Lenart12/etera-uart-bridge/pcb/optocupler.kicad_pcb

## KiCad design pcb/optocupler.kicad_pcb (2024-07-26)

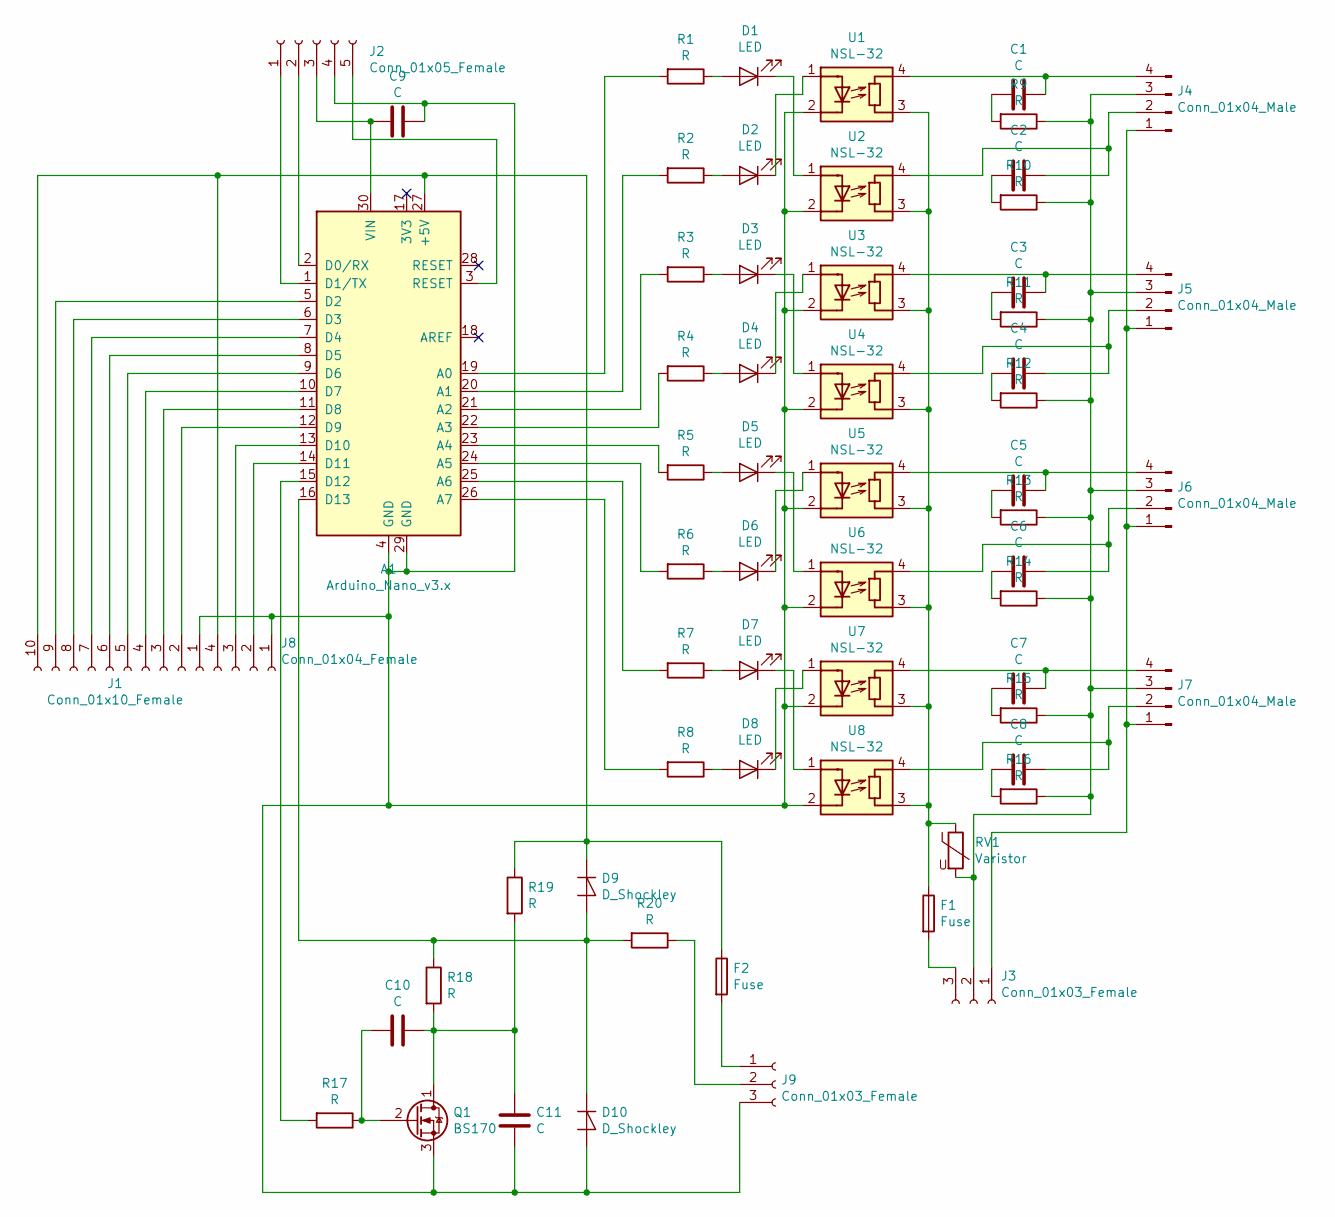
[picture p4: schematic optocupler.sch]

Parts:
A1: Arduino_Nano_v3.x; Arduino_Nano
C1, C2, C3, C4, C5, C6, C7, C8: C; C_Axial_L17.0mm_D6.5mm_P20.00mm_Horizontal
C9, C10, C11: C; C_Disc_D4.7mm_W2.5mm_P5.00mm
D1, D2, D3, D4, D5, D6, D7, D8: LED; LED_D5.0mm
D9, D10: D_Shockley; D_A-405_P10.16mm_Horizontal
F1, F2: Fuse; Fuseholder_Cylinder-5x20mm_Stelvio-Kontek_PTF78_Horizontal_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
J1: Conn_01x10_Female; PinSocket_1x10_P2.54mm_Vertical
J2: Conn_01x05_Female; PinSocket_1x05_P2.54mm_Vertical
J3, J9: Conn_01x03_Female; JST_NV_B03P-NV_1x03_P5.00mm_Vertical
J4, J5, J6, J7: Conn_01x04_Male; PhoenixContact_MSTBVA_2,5_4-G_1x04_P5.00mm_Vertical
J8: Conn_01x04_Female; PinSocket_1x04_P2.54mm_Vertical
Q1: BS170; TO-92_Inline
R1, R2, R3, R4, R5, R6, R7, R8, R9, R10, R11, R12, R13, R14, R15, R16, R17, R18, R19, R20: R; R_Axial_DIN0411_L9.9mm_D3.6mm_P12.70mm_Horizontal
RV1: Varistor; RV_Disc_D15.5mm_W4mm_P7.5mm
U1, U2, U3, U4, U5, U6, U7, U8: NSL-32; DIP-5-6_W7.62mm_LongPads

Connections:
unnamed: A1.1 (D1/TX), J2.1
unnamed: A1.2 (D0/RX), J2.2
unnamed: A1.3 (RESET), J2.5
unnamed: A1.5 (D2), J1.9
unnamed: A1.6 (D3), J1.8
unnamed: A1.7 (D4), J1.7
unnamed: A1.8 (D5), J1.6
unnamed: A1.9 (D6), J1.5
unnamed: A1.10 (D7), J1.4
unnamed: A1.11 (D8), J1.3
unnamed: A1.12 (D9), J1.2
unnamed: A1.13 (D10), J8.3
unnamed: A1.14 (D11), J8.2
unnamed: A1.15 (D12), R17.2
unnamed: A1.16 (D13), D9.2 (A), D10.1 (K), R18.1, R20.2
unnamed: A1.19 (A0), R1.2
unnamed: A1.20 (A1), R2.2
unnamed: A1.21 (A2), R3.2
unnamed: A1.22 (A3), R4.2
unnamed: A1.23 (A4), R5.2
unnamed: A1.24 (A5), R6.2
unnamed: A1.25 (A6), R7.2
unnamed: A1.26 (A7), R8.2
unnamed: A1.27 (+5V), D9.1 (K), F2.1, J1.10, J8.4, R19.1
unnamed: A1.4 (GND), A1.29 (GND), C9.1, C11.2, D10.2 (A), J1.1, J2.4, J8.1, J9.3, Q1.3 (S), U1.2 (K), U2.2 (K), U3.2 (K), U4.2 (K), U5.2 (K), U6.2 (K), U7.2 (K), U8.2 (K)
unnamed: A1.30 (VIN), C9.2, J2.3
unnamed: C1.1, R9.2
unnamed: C1.2, J4.4, U1.4 (R)
unnamed: C2.1, R10.2
unnamed: C2.2, J4.2, U2.4 (R)
unnamed: C3.1, R11.2
unnamed: C3.2, J5.4, U3.4 (R)
unnamed: C4.1, R12.2
unnamed: C4.2, J5.2, U4.4 (R)
unnamed: C5.1, R13.2
unnamed: C5.2, J6.4, U5.4 (R)
unnamed: C6.1, R14.2
unnamed: C6.2, J6.2, U6.4 (R)
unnamed: C7.1, R15.2
unnamed: C7.2, J7.4, U7.4 (R)
unnamed: C8.1, R16.2
unnamed: C8.2, J7.2, U8.4 (R)
unnamed: C10.1, C11.1, Q1.1 (D), R18.2, R19.2
unnamed: C10.2, Q1.2 (G), R17.1
unnamed: D1.1 (K), U2.1 (A)
unnamed: D1.2 (A), R1.1
unnamed: D2.1 (K), U1.1 (A)
unnamed: D2.2 (A), R2.1
unnamed: D3.1 (K), U4.1 (A)
unnamed: D3.2 (A), R3.1
unnamed: D4.1 (K), U3.1 (A)
unnamed: D4.2 (A), R4.1
unnamed: D5.1 (K), U6.1 (A)
unnamed: D5.2 (A), R5.1
unnamed: D6.1 (K), U5.1 (A)
unnamed: D6.2 (A), R6.1
unnamed: D7.1 (K), U8.1 (A)
unnamed: D7.2 (A), R7.1
unnamed: D8.1 (K), U7.1 (A)
unnamed: D8.2 (A), R8.1
unnamed: F1.1, RV1.1, U1.3 (R), U2.3 (R), U3.3 (R), U4.3 (R), U5.3 (R), U6.3 (R), U7.3 (R), U8.3 (R)
unnamed: F1.2, J3.3
unnamed: F2.2, J9.1
unnamed: J3.1, J4.1, J5.1, J6.1, J7.1
unnamed: J3.2, J4.3, J5.3, J6.3, J7.3, R9.1, R10.1, R11.1, R12.1, R13.1, R14.1, R15.1, R16.1, RV1.2
unnamed: J9.2, R20.1

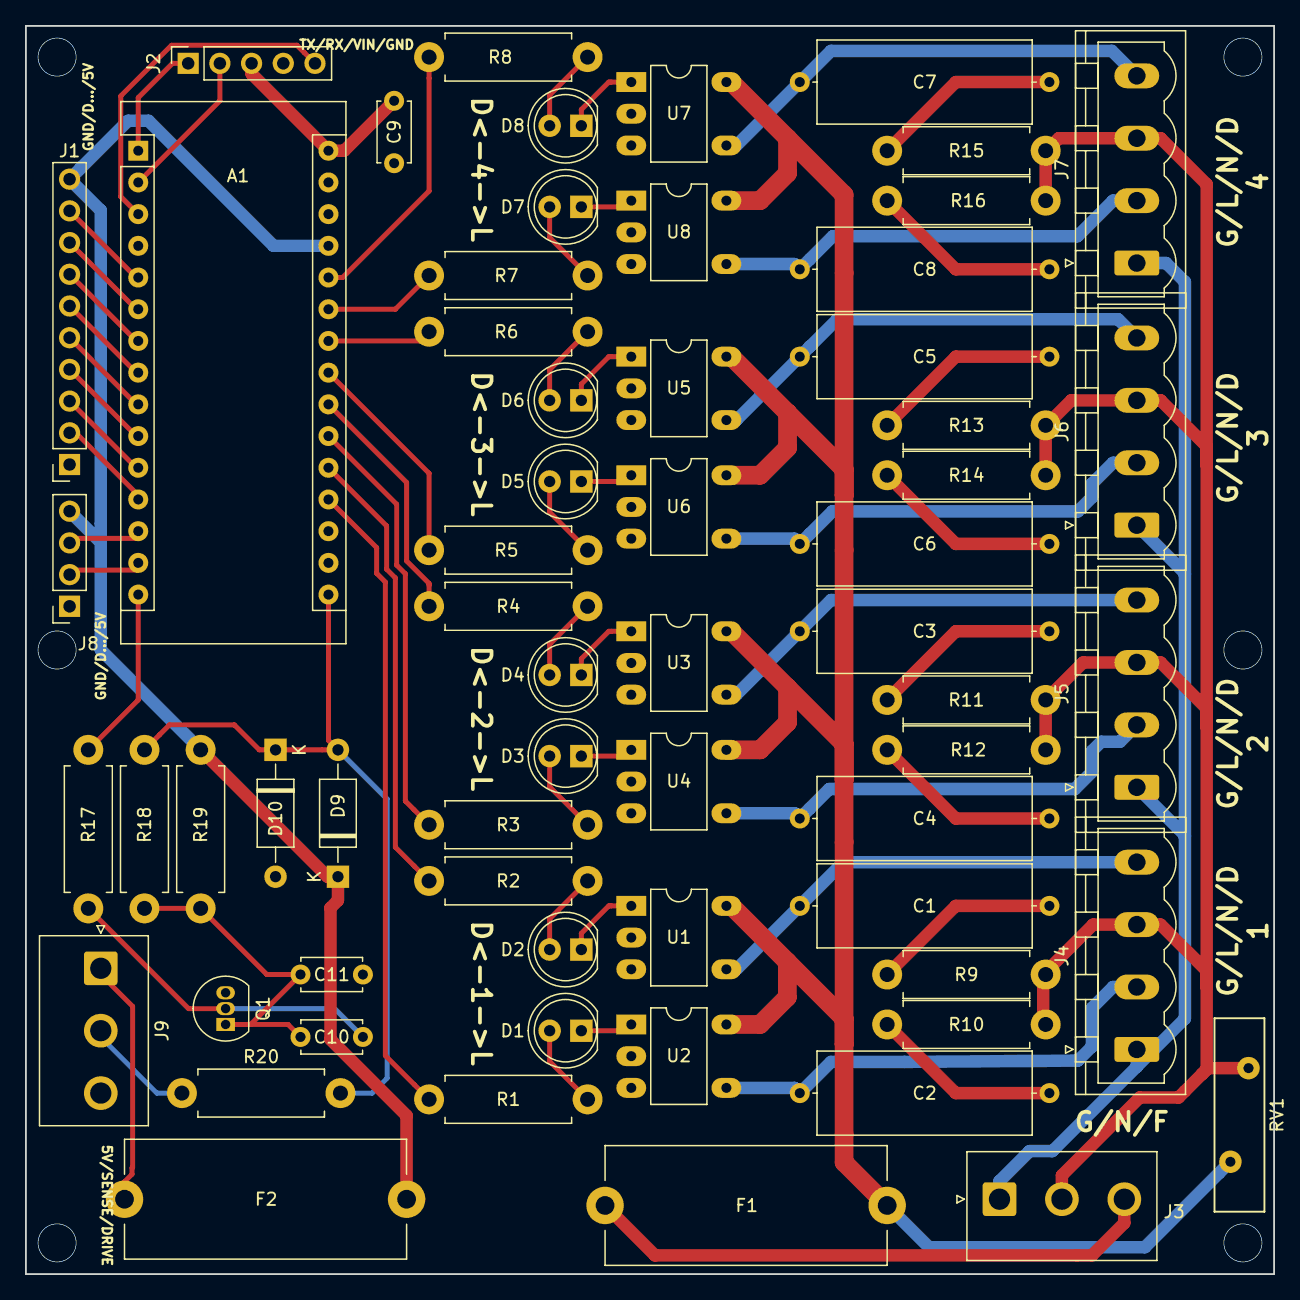
[picture p5: board optocupler.kicad_pcb from above]

Board: 2 copper layers, 100.0 x 100.0 mm, 63 parts (0 on the bottom side), 66 nets.
