Lenart12/etera-uart-bridge/pio-eub-firmware/src/TempController.cpp

#if !defined(__TEMP_CONTROLLER_CPP__)
#define __TEMP_CONTROLLER_CPP__

#include "TempController.hpp"
#include "ApplicationDefines.h"

void TempController::switch_state(State next, unsigned long timeout) {
    if (state != next) {
        state_start_millis = millis();
    }
    next_state.switch_state(state, next, timeout);
}

void TempController::NextState::switch_state(State& current, State next, unsigned long timeout) {
    if (timeout == 0) {
        current = next;
        return;
    }
    current = State::WAIT_SWITCH_STATE;
    state = next;
    timeout_start = millis();
    timeout_delay = timeout;
}

bool TempController::NextState::process_wait(State& current) {
    if (millis() - timeout_start < timeout_delay) return false;
    current = state;
    return true;
}

void PrintHex8_(uint8_t *data, uint8_t length) {
    for (int i = 0; i < length; i++) {
        if (data[i] < 0x10) Serial.print('0');
        Serial.print(data[i], HEX);
        if (i < length -1)
            Serial.print(':');
    }
}

void TempController::Process() {
    switch (state)
    {
    case State::SETUP: {
        // Free the memory if it was allocated before
        if (results) delete[] results;
        results = nullptr;

        #ifdef DEBUG_TEMP
        if (raw_temp) delete[] raw_temp;
        raw_temp = nullptr;
        if (count_remain) delete [] count_remain;
        count_remain = nullptr;
        #endif

        if (devices) {
            for (int i = 0; i < device_count; i++)
                delete[] devices[i];
            delete[] devices;
        }
        devices = nullptr;
        
        device_count = 0;
        last_read_millis = 0;

        if (!ds.reset()) {
            static bool shown_error = false;
            if (!shown_error) {
                TC_PRINTLN("1-Wire bus not found!");
                shown_error = true;
            }
            return;
        }

        // Get the number of devices on the bus
        byte addr[8];
        ds.reset_search();
        while (ds.search(addr)) device_count++;

        if (device_count == 0) {
            static bool shown_error = false;
            if (!shown_error) {
                TC_PRINTLN("No 1-Wire devices found!");
                shown_error = true;
            }
            return;
        }

        // Allocate memory for the results
        results = new int16_t[device_count];
        #ifdef DEBUG_TEMP
        raw_temp = new uint16_t[device_count];
        count_remain = new uint16_t[device_count];
        #endif
        #ifdef DOT765
        previous_temperature = new int16_t[device_count];
        #endif
        // Allocate memory for the addresses
        devices = new uint8_t*[device_count];
        for (int i = 0; i < device_count; i++) {
            results[i] = 0xFFFF;
            devices[i] = new uint8_t[8];
            #ifdef DOT765
            // Initialize to large positive temp so that
            // the previous temperature reading could not be used first time in a loop
            previous_temperature[i] = 0x8000; // Max signed int
            #endif
        }

        // Get the addresses of the devices
        ds.reset_search();
        for (int i = 0; i < device_count; i++)
        {
            ds.search(addr);
            for (int j = 0; j < 8; j++) devices[i][j] = addr[j];
        }

        TC_PRINT_START();
        Serial.print("Temperature Controller setup found ");
        Serial.print(device_count, DEC);
        Serial.println(" sensors.");
        Serial.println("Addresses:");
        for (int i = 0; i < device_count; i++) {
            Serial.print("#"); Serial.print(i, DEC);
            Serial.print("\t"); PrintHex8_(devices[i], 8);

            #ifdef READ_POWER_STATE
            ds.reset();
            ds.select(devices[i]);
            ds.write(0xB4); // Read power state command
            uint8_t power_state = ds.read_bit();
            Serial.print('\t');
            Serial.print(power_state ? "External" : "Parasite");
            #endif

            Serial.println();
        }
        TC_PRINT_END();


        switch_state(State::START_CONVERSION);
        break;
    }
    case State::START_CONVERSION: {
        ds.reset();
        ds.skip(); // We select all sensors and
        ds.write(0x44); // Start temperature conversion

        switch_state(State::WAIT_CONVERSION, 500);
        break;
    }
    case State::WAIT_CONVERSION: {
        // Check if the conversion is done every 5ms
        if (!ds.read_bit())
            return switch_state(state, 5);

        // Check for conversion timeout (2 seconds)
        if (millis() - state_start_millis > 2000) {
            TC_PRINTLN("Temperature conversion timeout!");
            switch_state(State::RESET_BUS, 1000);
            return;
        }

        current_device = 0;
        crc_error_count = 0;
        switch_state(State::READ);
        break;
    }
    case State::READ: {
        if (current_device >= device_count) {
            last_read_millis = millis(); // start over from the first sensor
            switch_state(State::START_CONVERSION);
            return;
        }

        const uint8_t* addr = devices[current_device];
        ds.reset();
        ds.select(addr);
        ds.write(0xBE); // Read scratchpad
        // Read temperature
        byte data[9];
        for (int j = 0; j < 9; j++)
        data[j] = ds.read();
        // Check CRC
        if (OneWireFet::crc8(data, 8) != data[8]) {
            if (++crc_error_count > 10) {
                switch_state(State::RESET_BUS, 1000);
                TC_PRINTLN("CRC check error!");
            }
            return;
        }

        // Convert the data to actual temperature
        int16_t raw = (data[1] << 8) | data[0];

        #ifdef DEBUG_TEMP
        raw_temp[current_device] = raw;
        #endif

        if (addr[0] == 0x10) {
            // DS18S20 or old DS1820 returns temperature in 1/128 degrees
            // Note that count_per_c register data[7] is not hardcoded to 16 for legacy DC1820 as stated
            // in http://myarduinotoy.blogspot.com/2013/02/12bit-result-from-ds18s20.html
            // byte 6: DS18S20: COUNT_REMAIN
            // byte 7: DS18S20: COUNT_PER_C
            // 	                                  COUNT_PER_C - COUNT_REMAIN
            //     TEMPERATURE = TEMP_READ - 0.25 + --------------------------
            //                                      COUNT_PER_C
            // and usually ranges from 78 to 108. Thefore, we multiply by 128 in order
            // to get sufficient precission. Similarly as in
            // https://github.com/milesburton/Arduino-Temperature-Control-Library/blob/master/DallasTemperature.cpp
            // https://github.com/milesburton/Arduino-Temperature-Control-Library/blob/65112b562fd37af68ed113c9a3925c09c4529e14/DallasTemperature.cpp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

            int16_t  dt = 128*(data[7]-data[6]); // multiply by 128
      
            #ifdef DEBUG_TEMP
            count_remain[current_device] = (data[7] << 8) | data[6];
            #endif

            dt /= data[7];
            raw = 64*(raw&0xFFFE) - 32 + dt; // 0.5*128=64 == (1<<6); 0.25*128=32
        
            #ifdef  DOT765
            if((data[6] == 0 || data[7]-data[6] <= 1 )  // We got .7[56] questionable temperature read
            && (raw-previous_temperature[current_device] > 10)) // is change more than +0.08K
                raw = previous_temperature[current_device]; // Then this is probably a glitch
            previous_temperature[current_device] = raw;
            #endif

        } else {
            byte cfg = (data[4] & 0x60);
            if      (cfg == 0x00) raw = raw & ~7; // 9  bit res, 93.75 ms
            else if (cfg == 0x20) raw = raw & ~3; // 10 bit res, 187.5 ms
            else if (cfg == 0x40) raw = raw & ~1; // 11 bit res, 375 ms
            raw = raw << 3; // multiply by 8
        }
        results[current_device] = raw;

        crc_error_count = 0;
        current_device++;

        switch_state(state);
        break;
    }
    case State::RESET_BUS: {
        if (millis() - state_start_millis > 60000) {
            TC_PRINTLN("1-Wire bus reset timeout!");
            // Try one last time to reset the bus inside setup
            switch_state(State::SETUP, 1000);
            return;
        }

        if (!ds.reset()) {
            TC_PRINTLN("1-Wire bus reset failed!");
            switch_state(state, 1000);
            return;
        }

        ds.reset_search();
        uint8_t addr[8];
        int i = 0;
        for (; ds.search(addr); i++) {
            if (i >= device_count) {
                TC_PRINTLN("1-Wire bus reset found more devices than expected!");
                switch_state(state, 1000);
                return;
            }
            if (memcmp(addr, devices[i], 8) != 0) {
                TC_PRINTLN("1-Wire bus reset found different device!");
                switch_state(state, 1000);
                return;
            }
        }

        if (i != device_count) {
            TC_PRINTLN("1-Wire bus reset found less devices than expected!");
            switch_state(state, 1000);
            return;
        }
        
        TC_PRINTLN("1-Wire bus reset successful!");
        switch_state(State::START_CONVERSION);
        break;
    }
    case State::WAIT_SWITCH_STATE: {
        next_state.process_wait(state);
        break;
    }
    default:
        TC_PRINTLN("TempController is in unknown state!");
        state = State::SETUP;
    }
}

#endif // __TEMP_CONTROLLER_CPP__
