Lenart12/etera-uart-bridge/pio-eub-firmware/set_build_version.py

import subprocess

from SCons.Script import Environment


def get_version_string():
    git_describe = subprocess.check_output(['git', 'describe', '--tags', '--dirty', '--always']).strip()
    print('Version: ' + git_describe.decode('utf-8'))
    return git_describe.decode('utf-8')


env = Environment()
env.Append(CPPDEFINES=[('EUB_VERSION', get_version_string())])
