Lenart12/etera-uart-bridge/(commit log)

2024-07-31 Add sensor status
2024-08-01 Add temperature reads to help
2024-08-01 Print number of sensors in setup
2024-08-01 Add reset key with r for testing in Kermit
    [main.cpp]
2024-08-16 Do not clear LSB for other sensors
2024-09-17 Add debug temperature logs to figure out problems when sporadic xy.7[56] reading occurs.
    [TempController.cpp, TempController.hpp, main.cpp]
2024-09-18 Add delays to TempController state switches
2024-09-20 Add switch_state for delay testing
2024-09-27 Implement .7[56] spikes filter that occour sporadicly in legacy DS1820 sensors
2024-09-27 Initialize to large positive temp so that the previous temperature reading could not be used first time in a loop
2024-10-03 Fix double free causing a crash after TempController detects a disconnected sensor
    [TempController.cpp]
2025-04-02 style: Fix indentation in TempController
    [EteraUartBridge.py, TempController.cpp]
2025-04-02 fix: Try to recover 1-wire bus instead of resetting
    [TempController.cpp, TempController.hpp]
2025-04-02 fix: Add hard recovery timeout
    [TempController.cpp]
2025-04-02 fix: Return 0x7FFF for invalid temperature and handle timeout in temperature reading
    [TempController.hpp, main.cpp]
2025-04-02 fix: Handle invalid temperature readings in pyeub
    [EteraUartBridge.py]
2025-04-03 fixup: handle pending data before sending command
    [EteraUartBridge.py]
2025-04-03 fixup: Read whole buffer before processing commands
    [EteraUartBridge.py]
2025-04-07 revert: Print addresses on boot
    [TempController.cpp]
2025-04-08 feat: Add power state reading for devices in TempController
2025-06-05 Fix f-string is missing placeholders
    [EteraUartBridge.py]
2025-06-05 Code style fixes checked by flake8
    [EteraUartBridge.py]
2026-03-27 Fix optional with future
    [EteraUartBridge.py]
